yang-json/60Keyboard/00Key-master/images/1.JPG

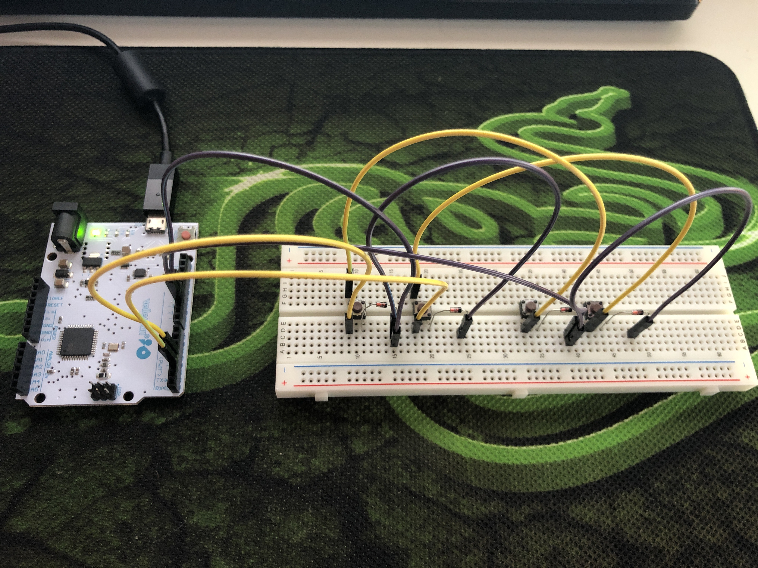
00Key-master/images/1.JPG
