yang-json/60Keyboard/00Key-master/images/5.jpeg

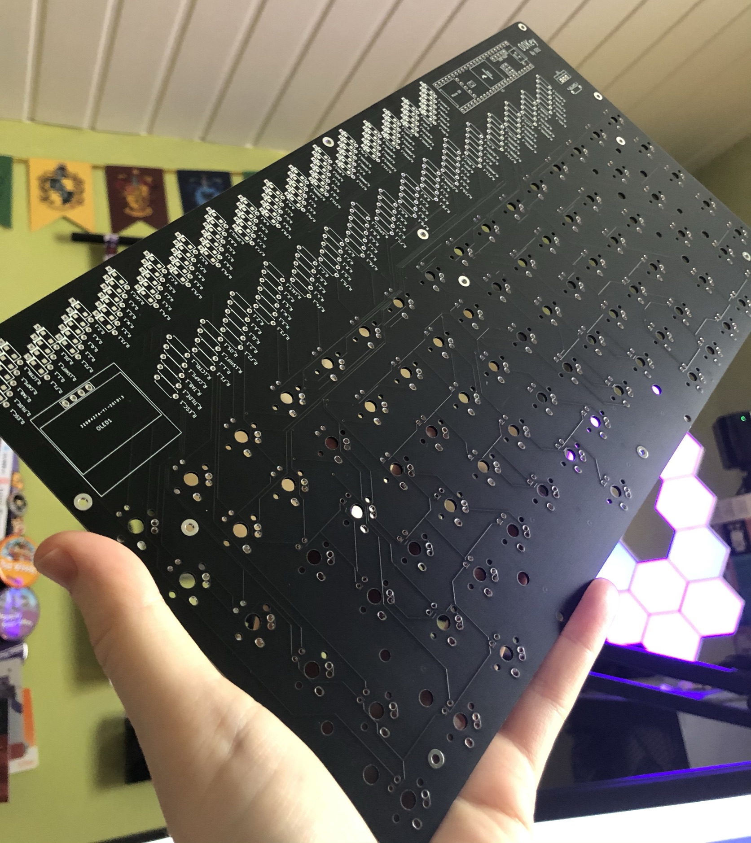
00Key-master/images/5.jpeg
