yang-json/60Keyboard/00Key-master/images/6.jpeg

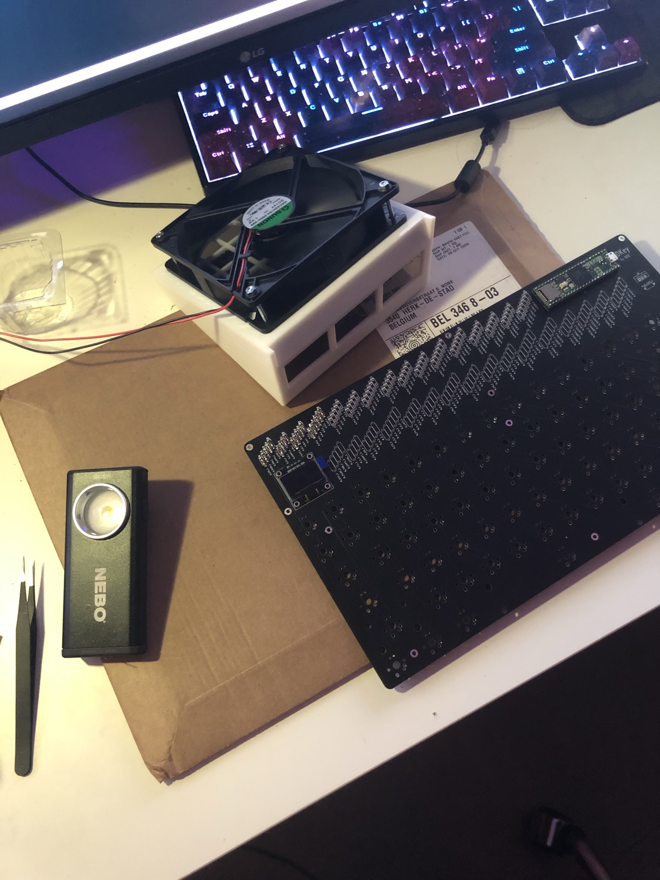
00Key-master/images/6.jpeg
