yang-json/60Keyboard/00Key-master/images/7.jpeg

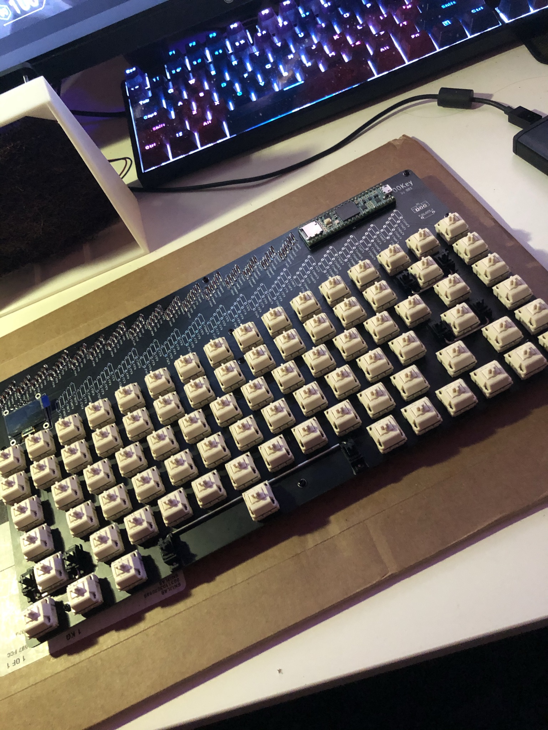
00Key-master/images/7.jpeg
