yang-json/60Keyboard/00Key-master/images/9.jpeg

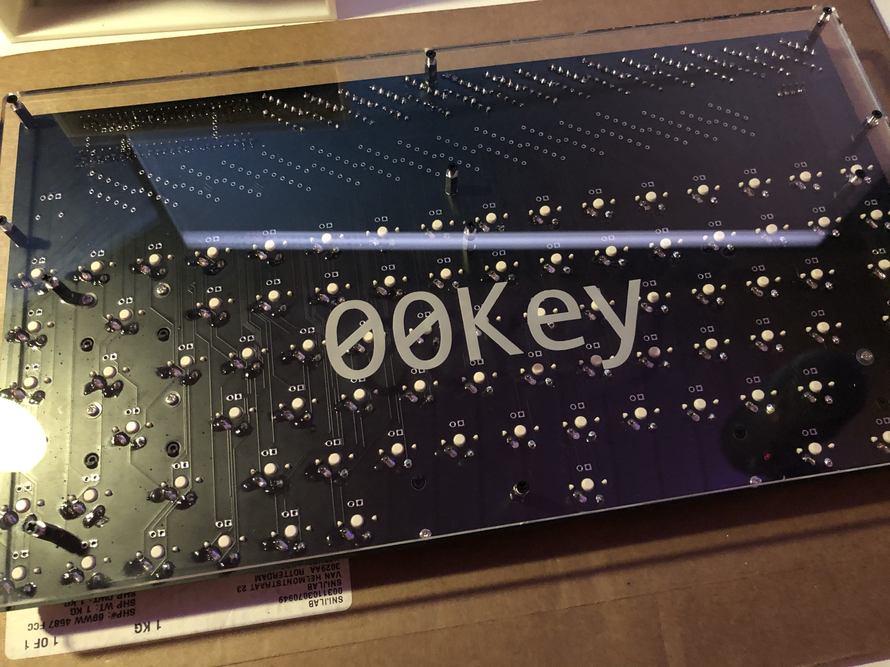
00Key-master/images/9.jpeg
