yang-json/60Keyboard/00Key-master/images/10.jpeg

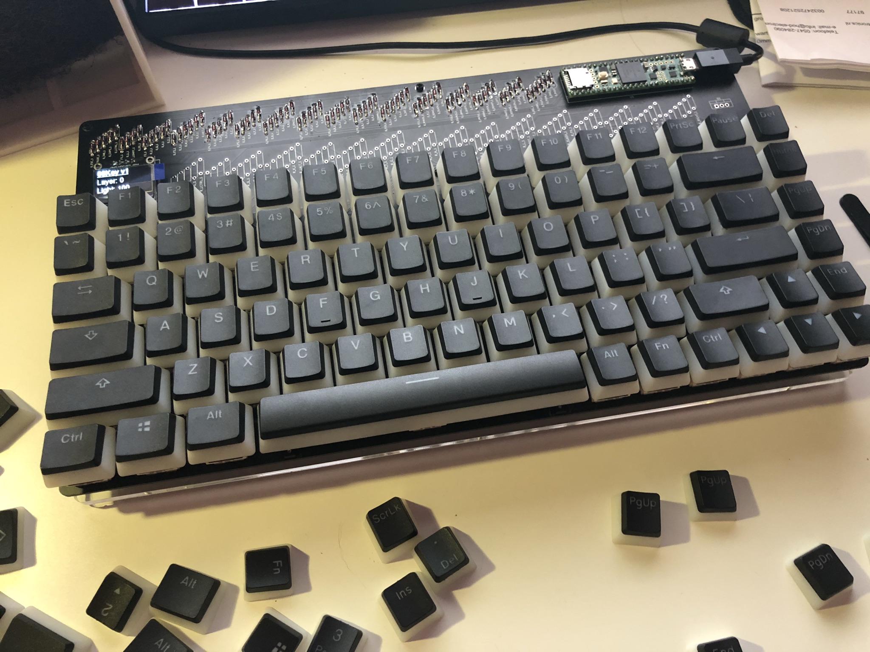
00Key-master/images/10.jpeg
