yang-json/60Keyboard/00Key-master/reference/pins.png

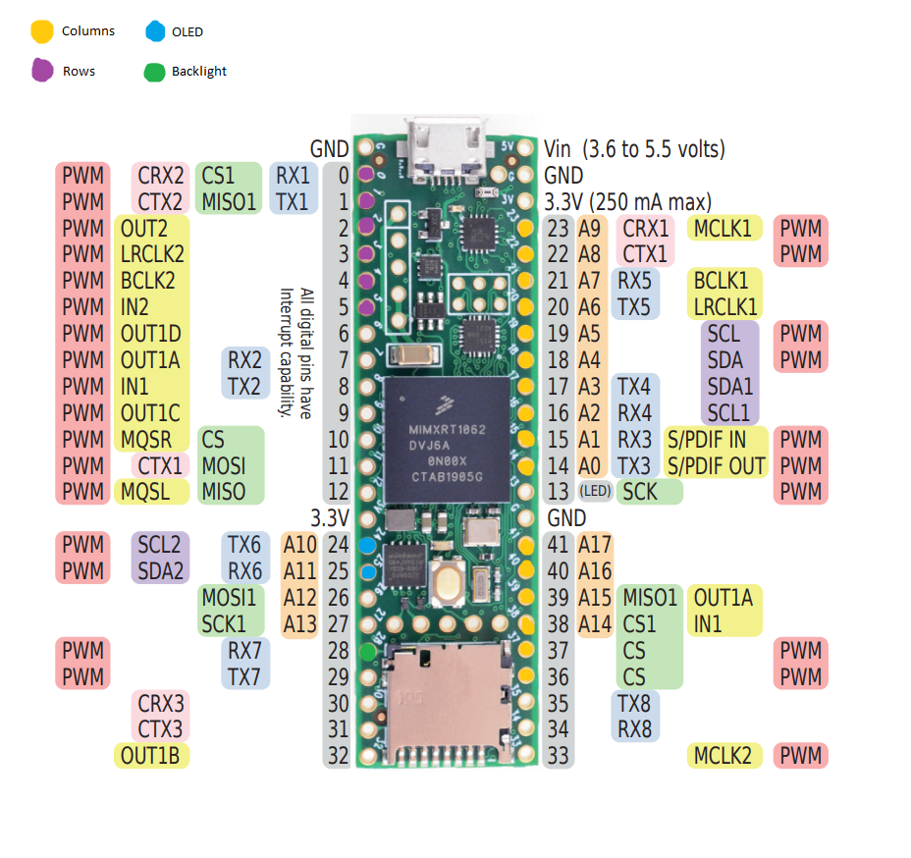
00Key-master/reference/pins.png
