yang-json/60Keyboard/Board layout.png

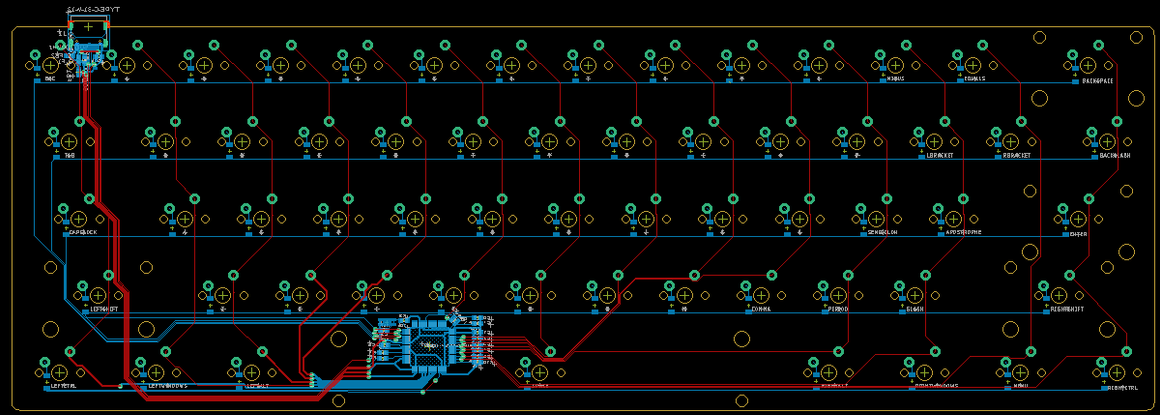
Board layout.png
