yang-json/60Keyboard/PCB bottom.png

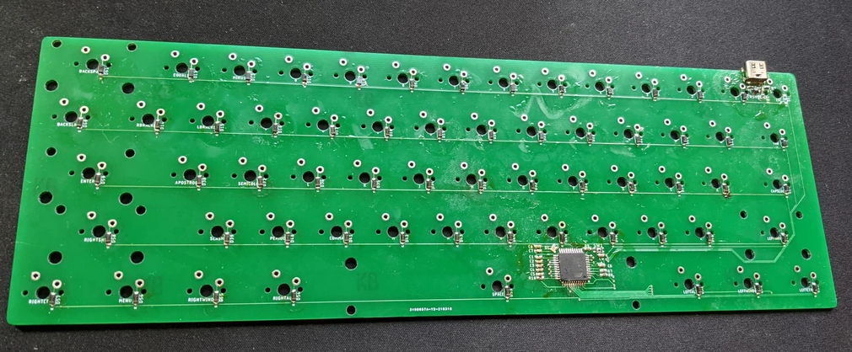
PCB bottom.png
