yang-json/60Keyboard/PCB schematic.png

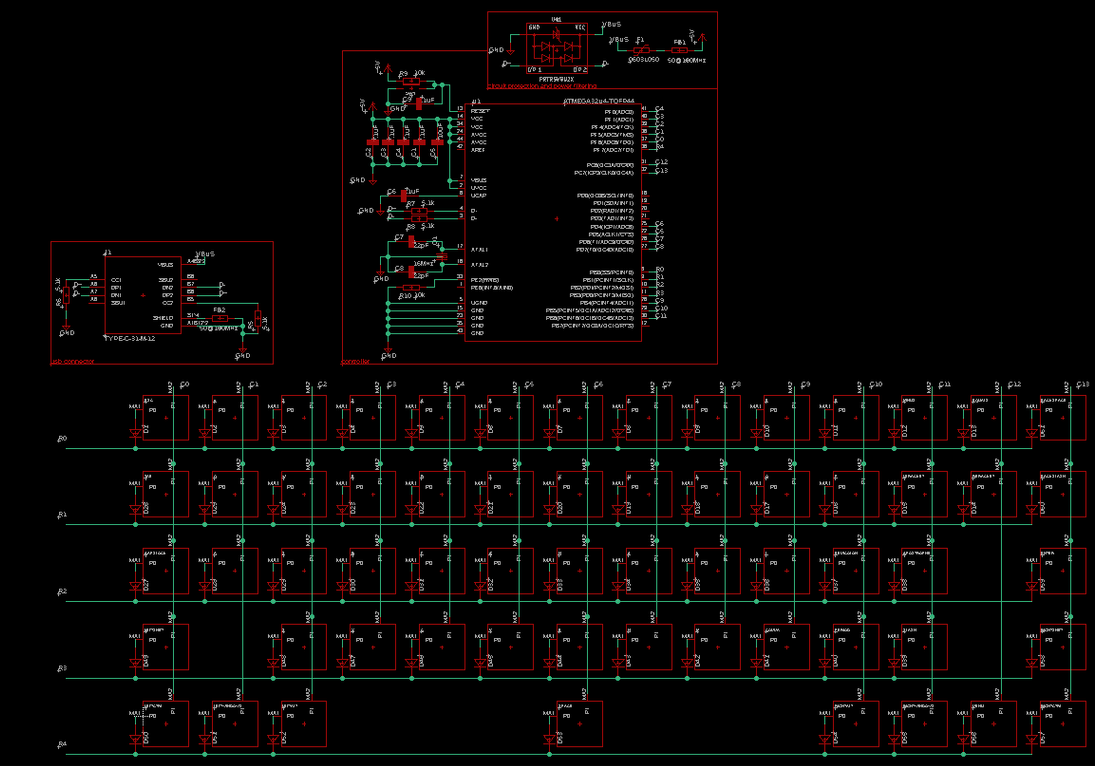
PCB schematic.png
