yang-json/60Keyboard/PCB top.png

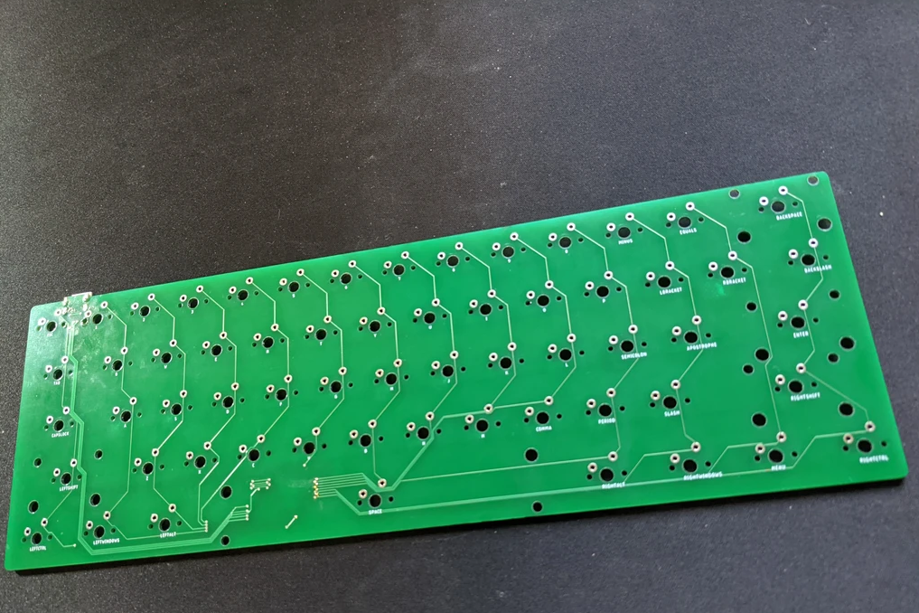
PCB top.png
