yang-json/60Keyboard/00Key-master/raiser/CAD/raiser.FCStd

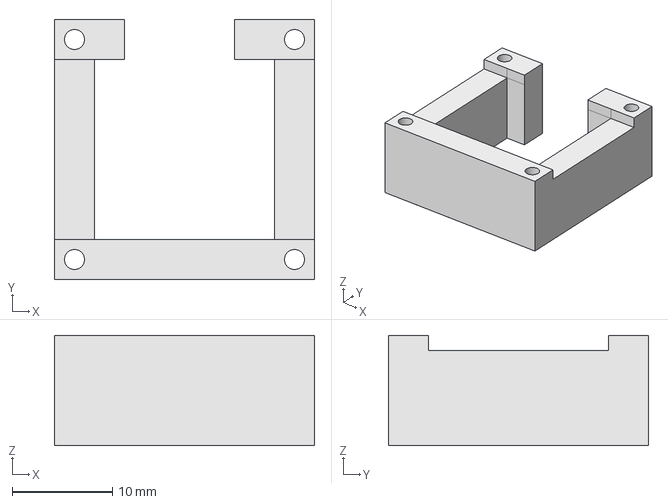
[picture p18: CAD file, 2024-01-08]
00Key-master/raiser/CAD/raiser.FCStd
26.0 x 26.0 x 11.0 mm
