yang-json/60Keyboard/00Key-master/underglow/CAD/underglow spacer.FCStd

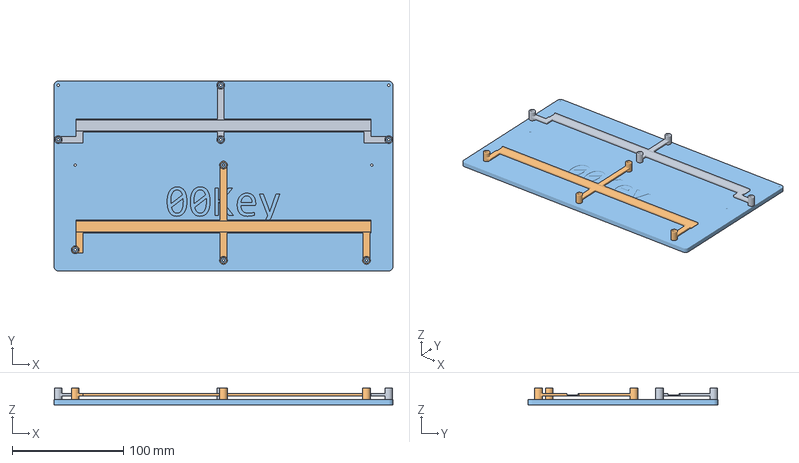
[picture p19: CAD file, 2024-01-08]
00Key-master/underglow/CAD/underglow spacer.FCStd
304.8 x 170.8 x 15.0 mm
top_all
bottom_all
plate
