yang-json/60Keyboard/00Key-master/underglow/STL/underglow_spacer_top.stl

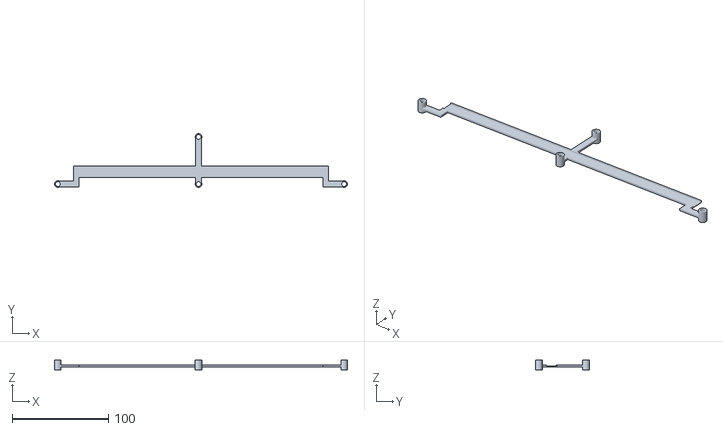
[picture p20: CAD file, 2024-01-08]
00Key-master/underglow/STL/underglow_spacer_top.stl
304.2 x 55.8 x 10.0
