yang-json/60Keyboard/a1d715fa3ec649b463cb42fbbe5cdb0abbd753b8_switch.dxf

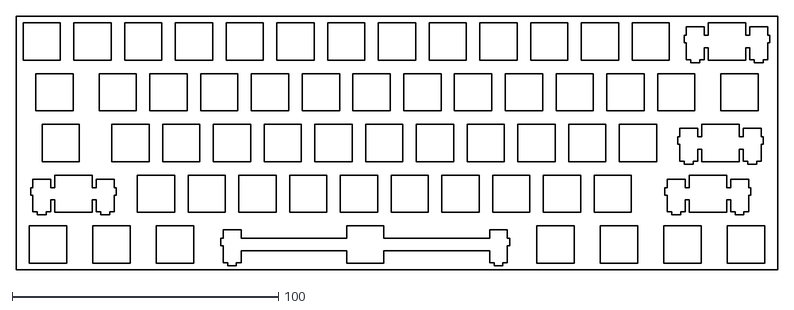
[picture p21: CAD file, 2024-01-08]
a1d715fa3ec649b463cb42fbbe5cdb0abbd753b8_switch.dxf
285.7 x 95.2
