yang-json/60Keyboard/00Key-master/plate/stl/right.stl

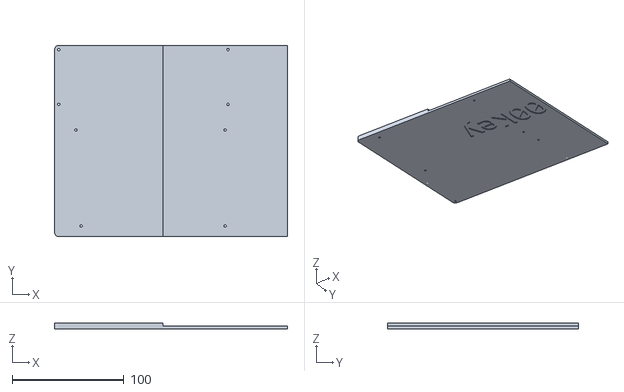
[picture p22: CAD file, 2024-01-08]
00Key-master/plate/stl/right.stl
208.1 x 170.8 x 5.00
