yang-json/60Keyboard/00Key-master/underglow/STL/underglow_spacer_bottom.stl

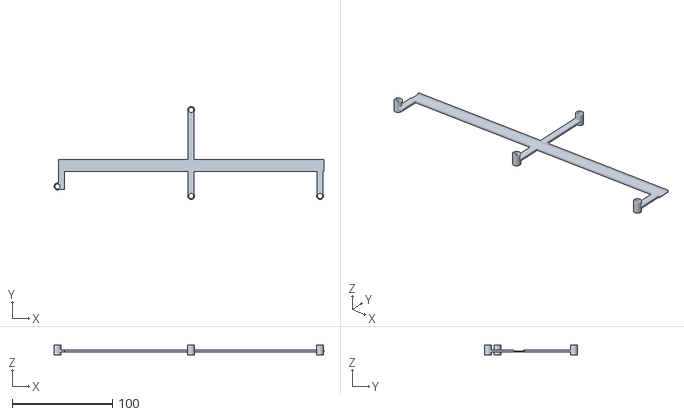
[picture p23: CAD file, 2024-01-08]
00Key-master/underglow/STL/underglow_spacer_bottom.stl
269.3 x 92.7 x 10.0
