yang-json/60Keyboard/00Key-master/underglow/STL/spacer.stl

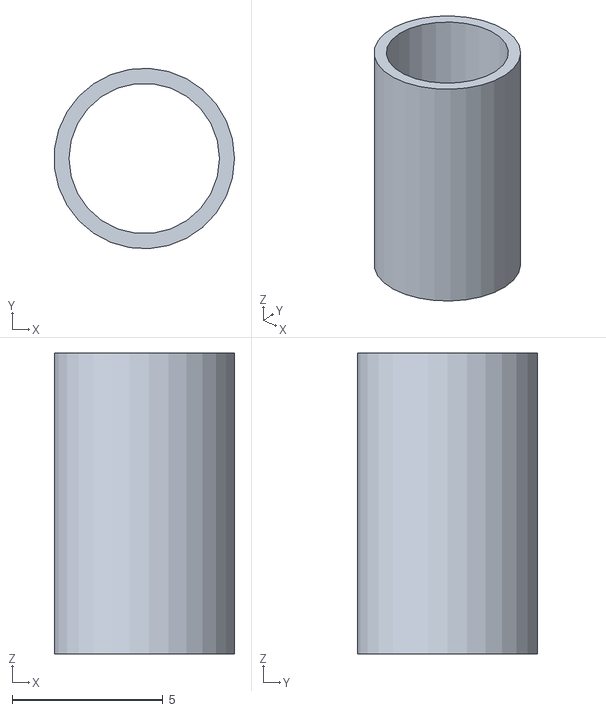
[picture p24: CAD file, 2024-01-08]
00Key-master/underglow/STL/spacer.stl
5.98 x 5.99 x 10.0
