yang-json/60Keyboard/(list of files, cad)

Other CAD files:
00Key-master/raiser/STL/raiser.stl
a1d715fa3ec649b463cb42fbbe5cdb0abbd753b8_switch.dwg
