yang-json/60Keyboard/00Key-master/images/build/DSCF2624.JPG

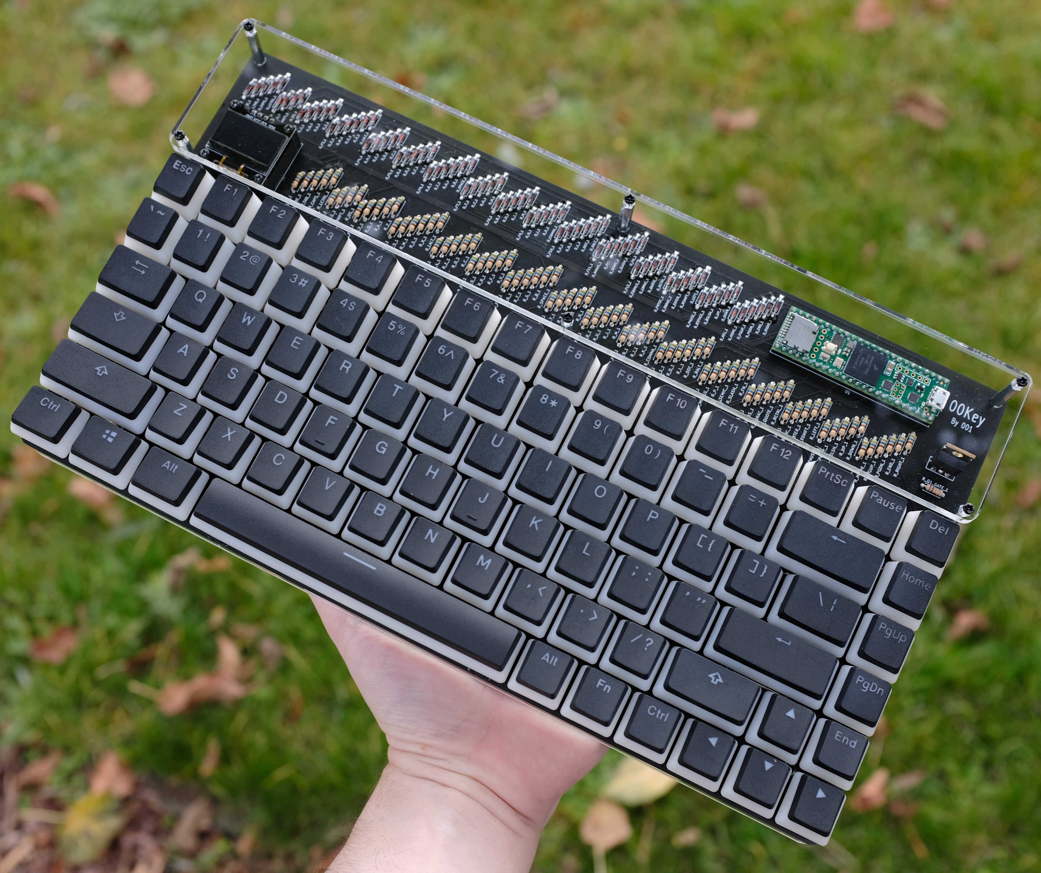
00Key-master/images/build/DSCF2624.JPG
