yang-json/60Keyboard/PCB assembled.png

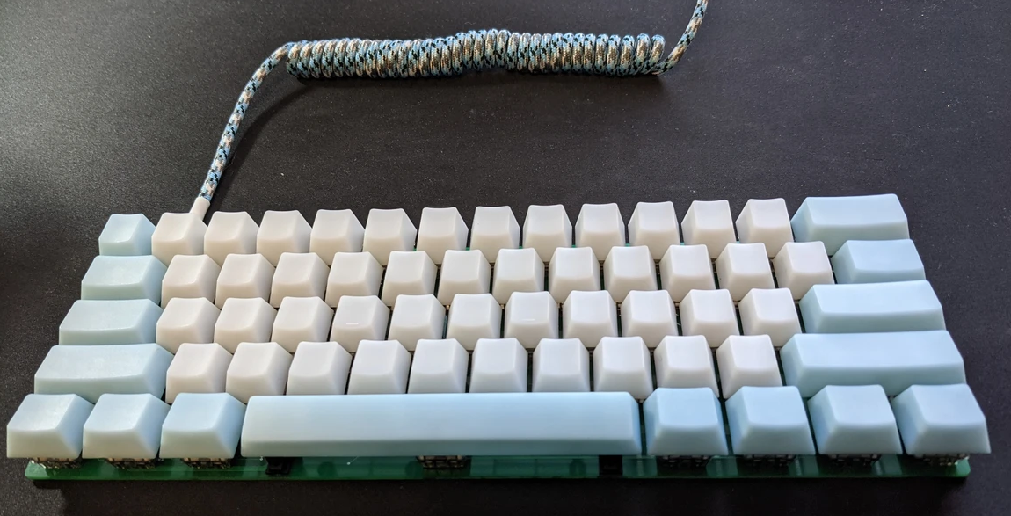
PCB assembled.png
