yang-json/60Keyboard/(list of files, drawings)

Other design files:
00Key-master/pcb/freerouting/00Key-out.dsn
00Key-master/pcb/freerouting/00Key.dsn
