yang-json/60Keyboard/00Key-master/pcb/kicad/00Key.kicad_pcb

## KiCad design 00Key-master/pcb/kicad/00Key.kicad_pcb (2024-01-08)

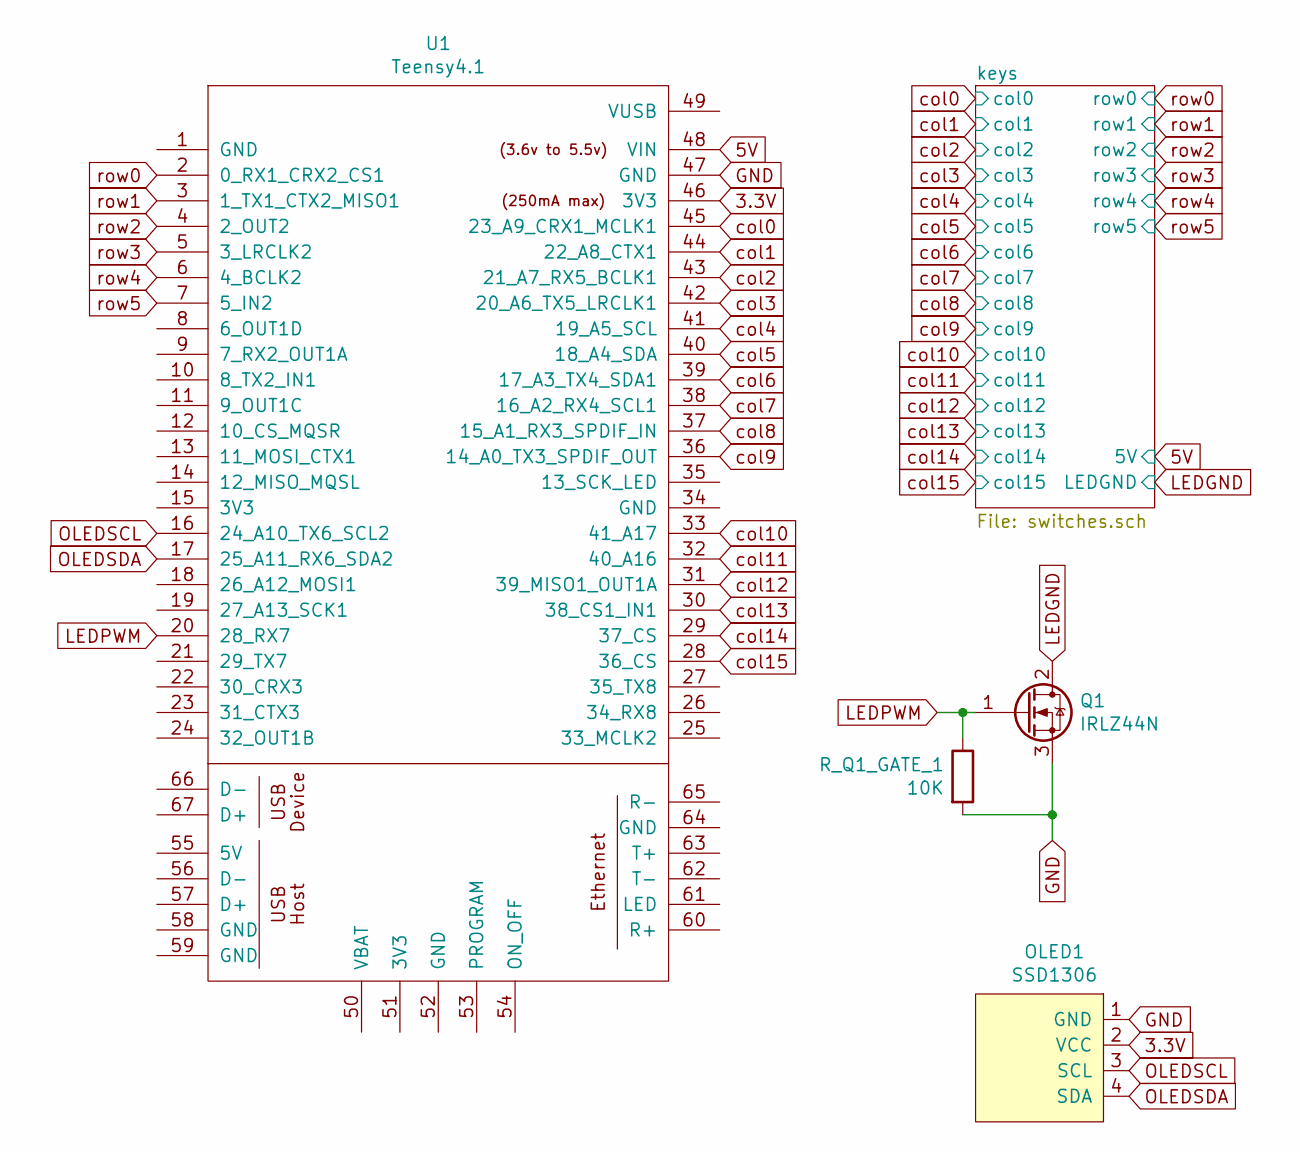
[picture p27: schematic 00Key.sch]

Parts:
OLED1: SSD1306; 128x64OLED
Q1: IRLZ44N; TO-220-3_Vertical
R_Q1_GATE_1: 10K; R_Axial_DIN0207_L6.3mm_D2.5mm_P7.62mm_Horizontal
U1: Teensy4.1; Teensy41

Connections:
3.3V: OLED1.2 (VCC), U1.46 (3V3)
5V: U1.48 (VIN); also elsewhere on the board
GND: OLED1.1 (GND), Q1.3 (S), R_Q1_GATE_1.2, U1.47 (GND)
LEDGND: Q1.2 (D); also elsewhere on the board
LEDPWM: Q1.1 (G), R_Q1_GATE_1.1, U1.20 (28_RX7)
OLEDSCL: OLED1.3 (SCL), U1.16 (24_A10_TX6_SCL2)
OLEDSDA: OLED1.4 (SDA), U1.17 (25_A11_RX6_SDA2)
col0: U1.45 (23_A9_CRX1_MCLK1); also elsewhere on the board
col1: U1.44 (22_A8_CTX1); also elsewhere on the board
col2: U1.43 (21_A7_RX5_BCLK1); also elsewhere on the board
col3: U1.42 (20_A6_TX5_LRCLK1); also elsewhere on the board
col4: U1.41 (19_A5_SCL); also elsewhere on the board
col5: U1.40 (18_A4_SDA); also elsewhere on the board
col6: U1.39 (17_A3_TX4_SDA1); also elsewhere on the board
col7: U1.38 (16_A2_RX4_SCL1); also elsewhere on the board
col8: U1.37 (15_A1_RX3_SPDIF_IN); also elsewhere on the board
col9: U1.36 (14_A0_TX3_SPDIF_OUT); also elsewhere on the board
col10: U1.33 (41_A17); also elsewhere on the board
col11: U1.32 (40_A16); also elsewhere on the board
col12: U1.31 (39_MISO1_OUT1A); also elsewhere on the board
col13: U1.30 (38_CS1_IN1); also elsewhere on the board
col14: U1.29 (37_CS); also elsewhere on the board
col15: U1.28 (36_CS); also elsewhere on the board
row0: U1.2 (0_RX1_CRX2_CS1); also elsewhere on the board
row1: U1.3 (1_TX1_CTX2_MISO1); also elsewhere on the board
row2: U1.4 (2_OUT2); also elsewhere on the board
row3: U1.5 (3_LRCLK2); also elsewhere on the board
row4: U1.6 (4_BCLK2); also elsewhere on the board
row5: U1.7 (5_IN2); also elsewhere on the board

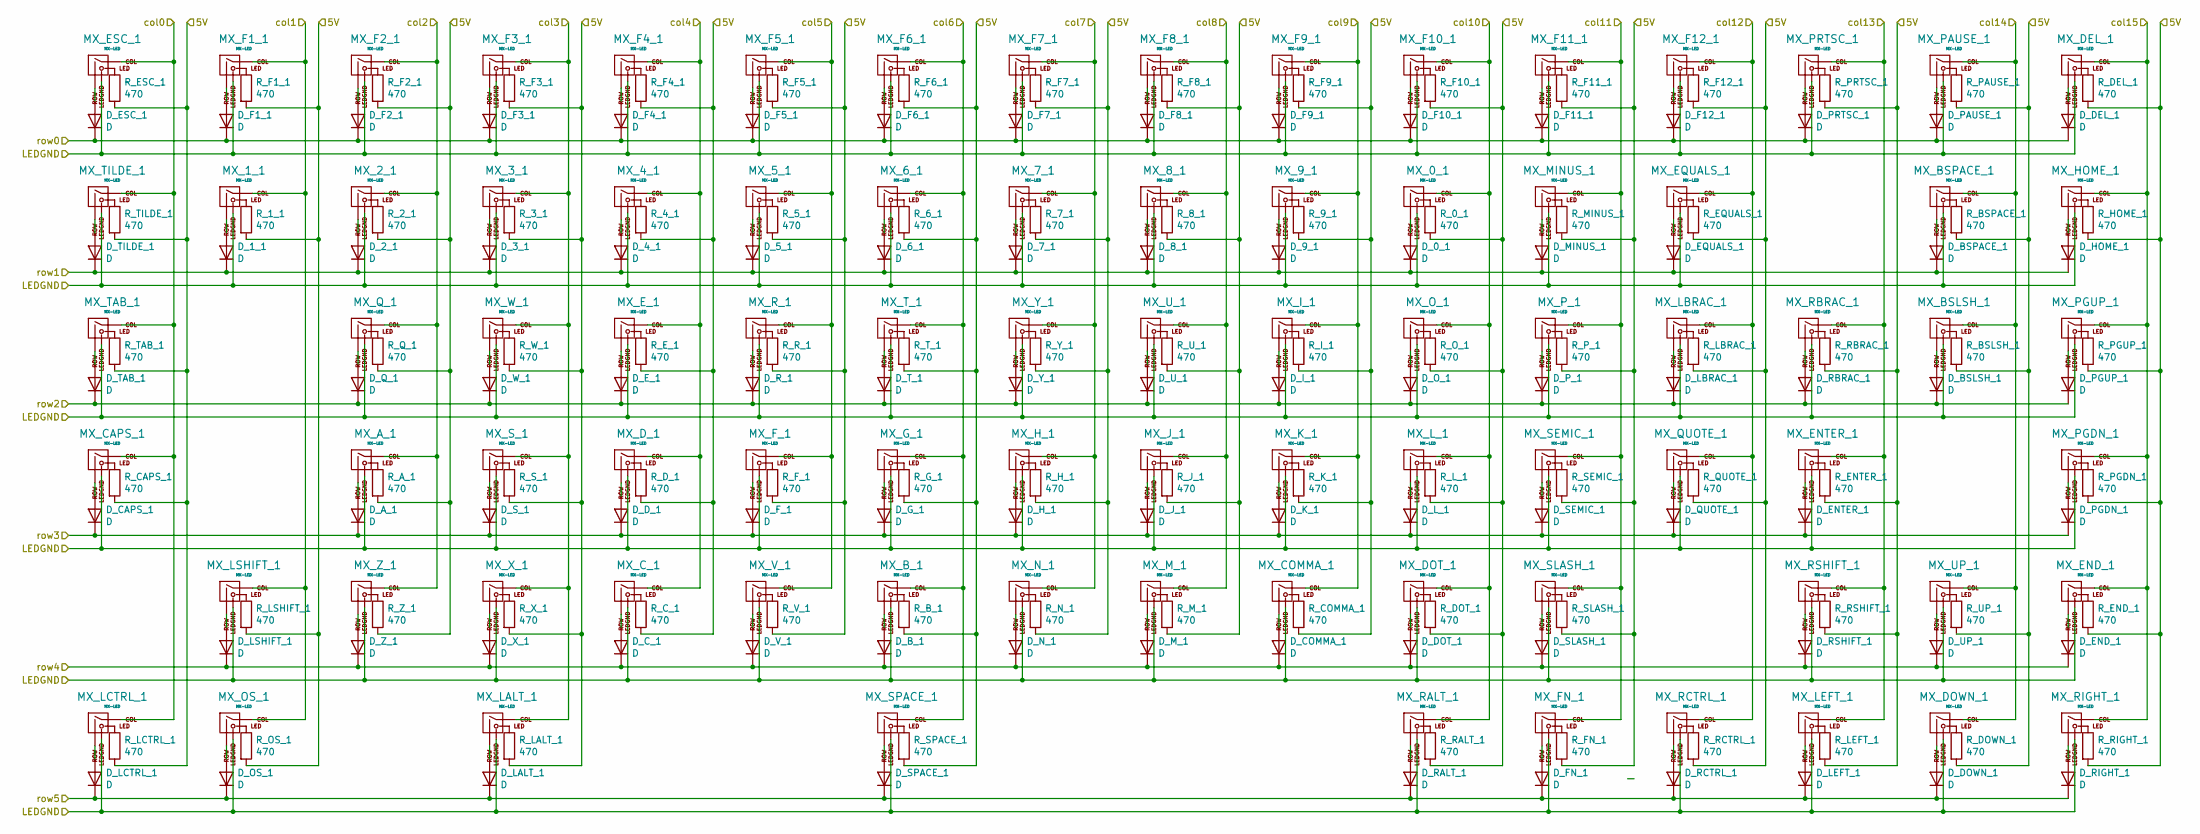
[picture p28: schematic switches.sch]

Parts:
D_0_1, D_1_1, D_2_1, D_3_1, D_4_1, D_5_1, D_6_1, D_7_1, D_8_1, D_9_1: D; D_SOD123_axial
D_A_1: D; D_SOD123_axial
D_BSLSH_1: D; D_SOD123_axial
D_BSPACE_1: D; D_SOD123_axial
D_B_1: D; D_SOD123_axial
D_CAPS_1: D; D_SOD123_axial
D_COMMA_1: D; D_SOD123_axial
D_C_1: D; D_SOD123_axial
D_DEL_1: D; D_SOD123_axial
D_DOT_1: D; D_SOD123_axial
D_DOWN_1: D; D_SOD123_axial
D_D_1: D; D_SOD123_axial
D_END_1: D; D_SOD123_axial
D_ENTER_1: D; D_SOD123_axial
D_EQUALS_1: D; D_SOD123_axial
D_ESC_1: D; D_SOD123_axial
D_E_1: D; D_SOD123_axial
D_F1_1, D_F2_1, D_F3_1, D_F4_1, D_F5_1, D_F6_1, D_F7_1, D_F8_1, D_F9_1, D_F10_1, D_F11_1, D_F12_1: D; D_SOD123_axial
D_FN_1: D; D_SOD123_axial
D_F_1: D; D_SOD123_axial
D_G_1: D; D_SOD123_axial
D_HOME_1: D; D_SOD123_axial
D_H_1: D; D_SOD123_axial
D_I_1: D; D_SOD123_axial
D_J_1: D; D_SOD123_axial
D_K_1: D; D_SOD123_axial
D_LALT_1: D; D_SOD123_axial
D_LBRAC_1: D; D_SOD123_axial
D_LCTRL_1: D; D_SOD123_axial
D_LEFT_1: D; D_SOD123_axial
D_LSHIFT_1: D; D_SOD123_axial
D_L_1: D; D_SOD123_axial
D_MINUS_1: D; D_SOD123_axial
D_M_1: D; D_SOD123_axial
D_N_1: D; D_SOD123_axial
D_OS_1: D; D_SOD123_axial
D_O_1: D; D_SOD123_axial
D_PAUSE_1: D; D_SOD123_axial
D_PGDN_1: D; D_SOD123_axial
D_PGUP_1: D; D_SOD123_axial
D_PRTSC_1: D; D_SOD123_axial
D_P_1: D; D_SOD123_axial
D_QUOTE_1: D; D_SOD123_axial
D_Q_1: D; D_SOD123_axial
D_RALT_1: D; D_SOD123_axial
D_RBRAC_1: D; D_SOD123_axial
D_RCTRL_1: D; D_SOD123_axial
D_RIGHT_1: D; D_SOD123_axial
D_RSHIFT_1: D; D_SOD123_axial
D_R_1: D; D_SOD123_axial
D_SEMIC_1: D; D_SOD123_axial
D_SLASH_1: D; D_SOD123_axial
D_SPACE_1: D; D_SOD123_axial
D_S_1: D; D_SOD123_axial
D_TAB_1: D; D_SOD123_axial
D_TILDE_1: D; D_SOD123_axial
D_T_1: D; D_SOD123_axial
D_UP_1: D; D_SOD123_axial
D_U_1: D; D_SOD123_axial
D_V_1: D; D_SOD123_axial
D_W_1: D; D_SOD123_axial
D_X_1: D; D_SOD123_axial
D_Y_1: D; D_SOD123_axial
D_Z_1: D; D_SOD123_axial
MX_0_1, MX_1_1, MX_2_1, MX_3_1, MX_4_1, MX_5_1, MX_6_1, MX_7_1, MX_8_1, MX_9_1: MX-LED; MX-1U
MX_A_1: MX-LED; MX-1U
MX_BSLSH_1: MX-LED; MX-1.5U
MX_BSPACE_1: MX-LED; MX-2U-ReversedStabilizers
MX_B_1: MX-LED; MX-1U
MX_CAPS_1: MX-LED; MX-1.75U
MX_COMMA_1: MX-LED; MX-1U
MX_C_1: MX-LED; MX-1U
MX_DEL_1: MX-LED; MX-1U
MX_DOT_1: MX-LED; MX-1U
MX_DOWN_1: MX-LED; MX-1U
MX_D_1: MX-LED; MX-1U
MX_END_1: MX-LED; MX-1U
MX_ENTER_1: MX-LED; MX-2.25U-ReversedStabilizers
MX_EQUALS_1: MX-LED; MX-1U
MX_ESC_1: MX-LED; MX-1U
MX_E_1: MX-LED; MX-1U
MX_F1_1, MX_F2_1, MX_F3_1, MX_F4_1, MX_F5_1, MX_F6_1, MX_F7_1, MX_F8_1, MX_F9_1, MX_F10_1, MX_F11_1, MX_F12_1: MX-LED; MX-1U
MX_FN_1: MX-LED; MX-1U
MX_F_1: MX-LED; MX-1U
MX_G_1: MX-LED; MX-1U
MX_HOME_1: MX-LED; MX-1U
MX_H_1: MX-LED; MX-1U
MX_I_1: MX-LED; MX-1U
MX_J_1: MX-LED; MX-1U
MX_K_1: MX-LED; MX-1U
MX_LALT_1: MX-LED; MX-1.25U
MX_LBRAC_1: MX-LED; MX-1U
MX_LCTRL_1: MX-LED; MX-1.25U
MX_LEFT_1: MX-LED; MX-1U
MX_LSHIFT_1: MX-LED; MX-2.25U-ReversedStabilizers
MX_L_1: MX-LED; MX-1U
MX_MINUS_1: MX-LED; MX-1U
MX_M_1: MX-LED; MX-1U
MX_N_1: MX-LED; MX-1U
MX_OS_1: MX-LED; MX-1.25U
MX_O_1: MX-LED; MX-1U
MX_PAUSE_1: MX-LED; MX-1U
MX_PGDN_1: MX-LED; MX-1U
MX_PGUP_1: MX-LED; MX-1U
MX_PRTSC_1: MX-LED; MX-1U
MX_P_1: MX-LED; MX-1U
MX_QUOTE_1: MX-LED; MX-1U
MX_Q_1: MX-LED; MX-1U
MX_RALT_1: MX-LED; MX-1U
MX_RBRAC_1: MX-LED; MX-1U
MX_RCTRL_1: MX-LED; MX-1U
MX_RIGHT_1: MX-LED; MX-1U
MX_RSHIFT_1: MX-LED; MX-1.75U
MX_R_1: MX-LED; MX-1U
MX_SEMIC_1: MX-LED; MX-1U
MX_SLASH_1: MX-LED; MX-1U
MX_SPACE_1: MX-LED; MX-6.25U
MX_S_1: MX-LED; MX-1U
MX_TAB_1: MX-LED; MX-1.5U
MX_TILDE_1: MX-LED; MX-1U
MX_T_1: MX-LED; MX-1U
MX_UP_1: MX-LED; MX-1U
MX_U_1: MX-LED; MX-1U
MX_V_1: MX-LED; MX-1U
MX_W_1: MX-LED; MX-1U
MX_X_1: MX-LED; MX-1U
MX_Y_1: MX-LED; MX-1U
MX_Z_1: MX-LED; MX-1U
R_0_1, R_1_1, R_2_1, R_3_1, R_4_1, R_5_1, R_6_1, R_7_1, R_8_1, R_9_1: 470; R_Axial_DIN0207_L6.3mm_D2.5mm_P7.62mm_Horizontal
R_A_1: 470; R_Axial_DIN0207_L6.3mm_D2.5mm_P7.62mm_Horizontal
R_BSLSH_1: 470; R_Axial_DIN0207_L6.3mm_D2.5mm_P7.62mm_Horizontal
R_BSPACE_1: 470; R_Axial_DIN0207_L6.3mm_D2.5mm_P7.62mm_Horizontal
R_B_1: 470; R_Axial_DIN0207_L6.3mm_D2.5mm_P7.62mm_Horizontal
R_CAPS_1: 470; R_Axial_DIN0207_L6.3mm_D2.5mm_P7.62mm_Horizontal
R_COMMA_1: 470; R_Axial_DIN0207_L6.3mm_D2.5mm_P7.62mm_Horizontal
R_C_1: 470; R_Axial_DIN0207_L6.3mm_D2.5mm_P7.62mm_Horizontal
R_DEL_1: 470; R_Axial_DIN0207_L6.3mm_D2.5mm_P7.62mm_Horizontal
R_DOT_1: 470; R_Axial_DIN0207_L6.3mm_D2.5mm_P7.62mm_Horizontal
R_DOWN_1: 470; R_Axial_DIN0207_L6.3mm_D2.5mm_P7.62mm_Horizontal
R_D_1: 470; R_Axial_DIN0207_L6.3mm_D2.5mm_P7.62mm_Horizontal
R_END_1: 470; R_Axial_DIN0207_L6.3mm_D2.5mm_P7.62mm_Horizontal
R_ENTER_1: 470; R_Axial_DIN0207_L6.3mm_D2.5mm_P7.62mm_Horizontal
R_EQUALS_1: 470; R_Axial_DIN0207_L6.3mm_D2.5mm_P7.62mm_Horizontal
R_ESC_1: 470; R_Axial_DIN0207_L6.3mm_D2.5mm_P7.62mm_Horizontal
R_E_1: 470; R_Axial_DIN0207_L6.3mm_D2.5mm_P7.62mm_Horizontal
R_F1_1, R_F2_1, R_F3_1, R_F4_1, R_F5_1, R_F6_1, R_F7_1, R_F8_1, R_F9_1, R_F10_1, R_F11_1, R_F12_1: 470; R_Axial_DIN0207_L6.3mm_D2.5mm_P7.62mm_Horizontal
R_FN_1: 470; R_Axial_DIN0207_L6.3mm_D2.5mm_P7.62mm_Horizontal
R_F_1: 470; R_Axial_DIN0207_L6.3mm_D2.5mm_P7.62mm_Horizontal
R_G_1: 470; R_Axial_DIN0207_L6.3mm_D2.5mm_P7.62mm_Horizontal
R_HOME_1: 470; R_Axial_DIN0207_L6.3mm_D2.5mm_P7.62mm_Horizontal
R_H_1: 470; R_Axial_DIN0207_L6.3mm_D2.5mm_P7.62mm_Horizontal
R_I_1: 470; R_Axial_DIN0207_L6.3mm_D2.5mm_P7.62mm_Horizontal
R_J_1: 470; R_Axial_DIN0207_L6.3mm_D2.5mm_P7.62mm_Horizontal
R_K_1: 470; R_Axial_DIN0207_L6.3mm_D2.5mm_P7.62mm_Horizontal
R_LALT_1: 470; R_Axial_DIN0207_L6.3mm_D2.5mm_P7.62mm_Horizontal
R_LBRAC_1: 470; R_Axial_DIN0207_L6.3mm_D2.5mm_P7.62mm_Horizontal
R_LCTRL_1: 470; R_Axial_DIN0207_L6.3mm_D2.5mm_P7.62mm_Horizontal
R_LEFT_1: 470; R_Axial_DIN0207_L6.3mm_D2.5mm_P7.62mm_Horizontal
R_LSHIFT_1: 470; R_Axial_DIN0207_L6.3mm_D2.5mm_P7.62mm_Horizontal
R_L_1: 470; R_Axial_DIN0207_L6.3mm_D2.5mm_P7.62mm_Horizontal
R_MINUS_1: 470; R_Axial_DIN0207_L6.3mm_D2.5mm_P7.62mm_Horizontal
R_M_1: 470; R_Axial_DIN0207_L6.3mm_D2.5mm_P7.62mm_Horizontal
R_N_1: 470; R_Axial_DIN0207_L6.3mm_D2.5mm_P7.62mm_Horizontal
R_OS_1: 470; R_Axial_DIN0207_L6.3mm_D2.5mm_P7.62mm_Horizontal
R_O_1: 470; R_Axial_DIN0207_L6.3mm_D2.5mm_P7.62mm_Horizontal
R_PAUSE_1: 470; R_Axial_DIN0207_L6.3mm_D2.5mm_P7.62mm_Horizontal
R_PGDN_1: 470; R_Axial_DIN0207_L6.3mm_D2.5mm_P7.62mm_Horizontal
R_PGUP_1: 470; R_Axial_DIN0207_L6.3mm_D2.5mm_P7.62mm_Horizontal
R_PRTSC_1: 470; R_Axial_DIN0207_L6.3mm_D2.5mm_P7.62mm_Horizontal
R_P_1: 470; R_Axial_DIN0207_L6.3mm_D2.5mm_P7.62mm_Horizontal
R_QUOTE_1: 470; R_Axial_DIN0207_L6.3mm_D2.5mm_P7.62mm_Horizontal
R_Q_1: 470; R_Axial_DIN0207_L6.3mm_D2.5mm_P7.62mm_Horizontal
R_RALT_1: 470; R_Axial_DIN0207_L6.3mm_D2.5mm_P7.62mm_Horizontal
R_RBRAC_1: 470; R_Axial_DIN0207_L6.3mm_D2.5mm_P7.62mm_Horizontal
R_RCTRL_1: 470; R_Axial_DIN0207_L6.3mm_D2.5mm_P7.62mm_Horizontal
R_RIGHT_1: 470; R_Axial_DIN0207_L6.3mm_D2.5mm_P7.62mm_Horizontal
R_RSHIFT_1: 470; R_Axial_DIN0207_L6.3mm_D2.5mm_P7.62mm_Horizontal
R_R_1: 470; R_Axial_DIN0207_L6.3mm_D2.5mm_P7.62mm_Horizontal
R_SEMIC_1: 470; R_Axial_DIN0207_L6.3mm_D2.5mm_P7.62mm_Horizontal
R_SLASH_1: 470; R_Axial_DIN0207_L6.3mm_D2.5mm_P7.62mm_Horizontal
R_SPACE_1: 470; R_Axial_DIN0207_L6.3mm_D2.5mm_P7.62mm_Horizontal
R_S_1: 470; R_Axial_DIN0207_L6.3mm_D2.5mm_P7.62mm_Horizontal
R_TAB_1: 470; R_Axial_DIN0207_L6.3mm_D2.5mm_P7.62mm_Horizontal
R_TILDE_1: 470; R_Axial_DIN0207_L6.3mm_D2.5mm_P7.62mm_Horizontal
R_T_1: 470; R_Axial_DIN0207_L6.3mm_D2.5mm_P7.62mm_Horizontal
R_UP_1: 470; R_Axial_DIN0207_L6.3mm_D2.5mm_P7.62mm_Horizontal
R_U_1: 470; R_Axial_DIN0207_L6.3mm_D2.5mm_P7.62mm_Horizontal
R_V_1: 470; R_Axial_DIN0207_L6.3mm_D2.5mm_P7.62mm_Horizontal
R_W_1: 470; R_Axial_DIN0207_L6.3mm_D2.5mm_P7.62mm_Horizontal
R_X_1: 470; R_Axial_DIN0207_L6.3mm_D2.5mm_P7.62mm_Horizontal
R_Y_1: 470; R_Axial_DIN0207_L6.3mm_D2.5mm_P7.62mm_Horizontal
R_Z_1: 470; R_Axial_DIN0207_L6.3mm_D2.5mm_P7.62mm_Horizontal

Connections:
5V: R_0_1.2, R_1_1.2, R_2_1.2, R_3_1.2, R_4_1.2, R_5_1.2, R_6_1.2, R_7_1.2, R_8_1.2, R_9_1.2, R_A_1.2, R_BSLSH_1.2, R_BSPACE_1.2, R_B_1.2, R_CAPS_1.2, R_COMMA_1.2, R_C_1.2, R_DEL_1.2, R_DOT_1.2, R_DOWN_1.2, R_D_1.2, R_END_1.2, R_ENTER_1.2, R_EQUALS_1.2, R_ESC_1.2, R_E_1.2, R_F1_1.2, R_F2_1.2, R_F3_1.2, R_F4_1.2, R_F5_1.2, R_F6_1.2, R_F7_1.2, R_F8_1.2, R_F9_1.2, R_F10_1.2, R_F11_1.2, R_F12_1.2, R_FN_1.2, R_F_1.2, R_G_1.2, R_HOME_1.2, R_H_1.2, R_I_1.2, R_J_1.2, R_K_1.2, R_LALT_1.2, R_LBRAC_1.2, R_LCTRL_1.2, R_LEFT_1.2, R_LSHIFT_1.2, R_L_1.2, R_MINUS_1.2, R_M_1.2, R_N_1.2, R_OS_1.2, R_O_1.2, R_PAUSE_1.2, R_PGDN_1.2, R_PGUP_1.2, R_PRTSC_1.2, R_P_1.2, R_QUOTE_1.2, R_Q_1.2, R_RALT_1.2, R_RBRAC_1.2, R_RCTRL_1.2, R_RIGHT_1.2, R_RSHIFT_1.2, R_R_1.2, R_SEMIC_1.2, R_SLASH_1.2, R_SPACE_1.2, R_S_1.2, R_TAB_1.2, R_TILDE_1.2, R_T_1.2, R_UP_1.2, R_U_1.2, R_V_1.2, R_W_1.2, R_X_1.2, R_Y_1.2, R_Z_1.2; also elsewhere on the board
LEDGND: MX_0_1.4 (LEDGND), MX_1_1.4 (LEDGND), MX_2_1.4 (LEDGND), MX_3_1.4 (LEDGND), MX_4_1.4 (LEDGND), MX_5_1.4 (LEDGND), MX_6_1.4 (LEDGND), MX_7_1.4 (LEDGND), MX_8_1.4 (LEDGND), MX_9_1.4 (LEDGND), MX_A_1.4 (LEDGND), MX_BSLSH_1.4 (LEDGND), MX_BSPACE_1.4 (LEDGND), MX_B_1.4 (LEDGND), MX_CAPS_1.4 (LEDGND), MX_COMMA_1.4 (LEDGND), MX_C_1.4 (LEDGND), MX_DEL_1.4 (LEDGND), MX_DOT_1.4 (LEDGND), MX_DOWN_1.4 (LEDGND), MX_D_1.4 (LEDGND), MX_END_1.4 (LEDGND), MX_ENTER_1.4 (LEDGND), MX_EQUALS_1.4 (LEDGND), MX_ESC_1.4 (LEDGND), MX_E_1.4 (LEDGND), MX_F1_1.4 (LEDGND), MX_F2_1.4 (LEDGND), MX_F3_1.4 (LEDGND), MX_F4_1.4 (LEDGND), MX_F5_1.4 (LEDGND), MX_F6_1.4 (LEDGND), MX_F7_1.4 (LEDGND), MX_F8_1.4 (LEDGND), MX_F9_1.4 (LEDGND), MX_F10_1.4 (LEDGND), MX_F11_1.4 (LEDGND), MX_F12_1.4 (LEDGND), MX_FN_1.4 (LEDGND), MX_F_1.4 (LEDGND), MX_G_1.4 (LEDGND), MX_HOME_1.4 (LEDGND), MX_H_1.4 (LEDGND), MX_I_1.4 (LEDGND), MX_J_1.4 (LEDGND), MX_K_1.4 (LEDGND), MX_LALT_1.4 (LEDGND), MX_LBRAC_1.4 (LEDGND), MX_LCTRL_1.4 (LEDGND), MX_LEFT_1.4 (LEDGND), MX_LSHIFT_1.4 (LEDGND), MX_L_1.4 (LEDGND), MX_MINUS_1.4 (LEDGND), MX_M_1.4 (LEDGND), MX_N_1.4 (LEDGND), MX_OS_1.4 (LEDGND), MX_O_1.4 (LEDGND), MX_PAUSE_1.4 (LEDGND), MX_PGDN_1.4 (LEDGND), MX_PGUP_1.4 (LEDGND), MX_PRTSC_1.4 (LEDGND), MX_P_1.4 (LEDGND), MX_QUOTE_1.4 (LEDGND), MX_Q_1.4 (LEDGND), MX_RALT_1.4 (LEDGND), MX_RBRAC_1.4 (LEDGND), MX_RCTRL_1.4 (LEDGND), MX_RIGHT_1.4 (LEDGND), MX_RSHIFT_1.4 (LEDGND), MX_R_1.4 (LEDGND), MX_SEMIC_1.4 (LEDGND), MX_SLASH_1.4 (LEDGND), MX_SPACE_1.4 (LEDGND), MX_S_1.4 (LEDGND), MX_TAB_1.4 (LEDGND), MX_TILDE_1.4 (LEDGND), MX_T_1.4 (LEDGND), MX_UP_1.4 (LEDGND), MX_U_1.4 (LEDGND), MX_V_1.4 (LEDGND), MX_W_1.4 (LEDGND), MX_X_1.4 (LEDGND), MX_Y_1.4 (LEDGND), MX_Z_1.4 (LEDGND); also elsewhere on the board
unnamed: D_0_1.2 (A), MX_0_1.2 (ROW)
unnamed: D_1_1.2 (A), MX_1_1.2 (ROW)
unnamed: D_2_1.2 (A), MX_2_1.2 (ROW)
unnamed: D_3_1.2 (A), MX_3_1.2 (ROW)
unnamed: D_4_1.2 (A), MX_4_1.2 (ROW)
unnamed: D_5_1.2 (A), MX_5_1.2 (ROW)
unnamed: D_6_1.2 (A), MX_6_1.2 (ROW)
unnamed: D_7_1.2 (A), MX_7_1.2 (ROW)
unnamed: D_8_1.2 (A), MX_8_1.2 (ROW)
unnamed: D_9_1.2 (A), MX_9_1.2 (ROW)
unnamed: D_A_1.2 (A), MX_A_1.2 (ROW)
unnamed: D_BSLSH_1.2 (A), MX_BSLSH_1.2 (ROW)
unnamed: D_BSPACE_1.2 (A), MX_BSPACE_1.2 (ROW)
unnamed: D_B_1.2 (A), MX_B_1.2 (ROW)
unnamed: D_CAPS_1.2 (A), MX_CAPS_1.2 (ROW)
unnamed: D_COMMA_1.2 (A), MX_COMMA_1.2 (ROW)
unnamed: D_C_1.2 (A), MX_C_1.2 (ROW)
unnamed: D_DEL_1.2 (A), MX_DEL_1.2 (ROW)
unnamed: D_DOT_1.2 (A), MX_DOT_1.2 (ROW)
unnamed: D_DOWN_1.2 (A), MX_DOWN_1.2 (ROW)
unnamed: D_D_1.2 (A), MX_D_1.2 (ROW)
unnamed: D_END_1.2 (A), MX_END_1.2 (ROW)
unnamed: D_ENTER_1.2 (A), MX_ENTER_1.2 (ROW)
unnamed: D_EQUALS_1.2 (A), MX_EQUALS_1.2 (ROW)
unnamed: D_ESC_1.2 (A), MX_ESC_1.2 (ROW)
unnamed: D_E_1.2 (A), MX_E_1.2 (ROW)
unnamed: D_F1_1.2 (A), MX_F1_1.2 (ROW)
unnamed: D_F2_1.2 (A), MX_F2_1.2 (ROW)
unnamed: D_F3_1.2 (A), MX_F3_1.2 (ROW)
unnamed: D_F4_1.2 (A), MX_F4_1.2 (ROW)
unnamed: D_F5_1.2 (A), MX_F5_1.2 (ROW)
unnamed: D_F6_1.2 (A), MX_F6_1.2 (ROW)
unnamed: D_F7_1.2 (A), MX_F7_1.2 (ROW)
unnamed: D_F8_1.2 (A), MX_F8_1.2 (ROW)
unnamed: D_F9_1.2 (A), MX_F9_1.2 (ROW)
unnamed: D_F10_1.2 (A), MX_F10_1.2 (ROW)
unnamed: D_F11_1.2 (A), MX_F11_1.2 (ROW)
unnamed: D_F12_1.2 (A), MX_F12_1.2 (ROW)
unnamed: D_FN_1.2 (A), MX_FN_1.2 (ROW)
unnamed: D_F_1.2 (A), MX_F_1.2 (ROW)
unnamed: D_G_1.2 (A), MX_G_1.2 (ROW)
unnamed: D_HOME_1.2 (A), MX_HOME_1.2 (ROW)
unnamed: D_H_1.2 (A), MX_H_1.2 (ROW)
unnamed: D_I_1.2 (A), MX_I_1.2 (ROW)
unnamed: D_J_1.2 (A), MX_J_1.2 (ROW)
unnamed: D_K_1.2 (A), MX_K_1.2 (ROW)
unnamed: D_LALT_1.2 (A), MX_LALT_1.2 (ROW)
unnamed: D_LBRAC_1.2 (A), MX_LBRAC_1.2 (ROW)
unnamed: D_LCTRL_1.2 (A), MX_LCTRL_1.2 (ROW)
unnamed: D_LEFT_1.2 (A), MX_LEFT_1.2 (ROW)
unnamed: D_LSHIFT_1.2 (A), MX_LSHIFT_1.2 (ROW)
unnamed: D_L_1.2 (A), MX_L_1.2 (ROW)
unnamed: D_MINUS_1.2 (A), MX_MINUS_1.2 (ROW)
unnamed: D_M_1.2 (A), MX_M_1.2 (ROW)
unnamed: D_N_1.2 (A), MX_N_1.2 (ROW)
unnamed: D_OS_1.2 (A), MX_OS_1.2 (ROW)
unnamed: D_O_1.2 (A), MX_O_1.2 (ROW)
unnamed: D_PAUSE_1.2 (A), MX_PAUSE_1.2 (ROW)
unnamed: D_PGDN_1.2 (A), MX_PGDN_1.2 (ROW)
unnamed: D_PGUP_1.2 (A), MX_PGUP_1.2 (ROW)
unnamed: D_PRTSC_1.2 (A), MX_PRTSC_1.2 (ROW)
unnamed: D_P_1.2 (A), MX_P_1.2 (ROW)
unnamed: D_QUOTE_1.2 (A), MX_QUOTE_1.2 (ROW)
unnamed: D_Q_1.2 (A), MX_Q_1.2 (ROW)
unnamed: D_RALT_1.2 (A), MX_RALT_1.2 (ROW)
unnamed: D_RBRAC_1.2 (A), MX_RBRAC_1.2 (ROW)
unnamed: D_RCTRL_1.2 (A), MX_RCTRL_1.2 (ROW)
unnamed: D_RIGHT_1.2 (A), MX_RIGHT_1.2 (ROW)
unnamed: D_RSHIFT_1.2 (A), MX_RSHIFT_1.2 (ROW)
unnamed: D_R_1.2 (A), MX_R_1.2 (ROW)
unnamed: D_SEMIC_1.2 (A), MX_SEMIC_1.2 (ROW)
unnamed: D_SLASH_1.2 (A), MX_SLASH_1.2 (ROW)
unnamed: D_SPACE_1.2 (A), MX_SPACE_1.2 (ROW)
unnamed: D_S_1.2 (A), MX_S_1.2 (ROW)
unnamed: D_TAB_1.2 (A), MX_TAB_1.2 (ROW)
unnamed: D_TILDE_1.2 (A), MX_TILDE_1.2 (ROW)
unnamed: D_T_1.2 (A), MX_T_1.2 (ROW)
unnamed: D_UP_1.2 (A), MX_UP_1.2 (ROW)
unnamed: D_U_1.2 (A), MX_U_1.2 (ROW)
unnamed: D_V_1.2 (A), MX_V_1.2 (ROW)
unnamed: D_W_1.2 (A), MX_W_1.2 (ROW)
unnamed: D_X_1.2 (A), MX_X_1.2 (ROW)
unnamed: D_Y_1.2 (A), MX_Y_1.2 (ROW)
unnamed: D_Z_1.2 (A), MX_Z_1.2 (ROW)
unnamed: MX_0_1.3 (LED), R_0_1.1
unnamed: MX_1_1.3 (LED), R_1_1.1
unnamed: MX_2_1.3 (LED), R_2_1.1
unnamed: MX_3_1.3 (LED), R_3_1.1
unnamed: MX_4_1.3 (LED), R_4_1.1
unnamed: MX_5_1.3 (LED), R_5_1.1
unnamed: MX_6_1.3 (LED), R_6_1.1
unnamed: MX_7_1.3 (LED), R_7_1.1
unnamed: MX_8_1.3 (LED), R_8_1.1
unnamed: MX_9_1.3 (LED), R_9_1.1
unnamed: MX_A_1.3 (LED), R_A_1.1
unnamed: MX_BSLSH_1.3 (LED), R_BSLSH_1.1
unnamed: MX_BSPACE_1.3 (LED), R_BSPACE_1.1
unnamed: MX_B_1.3 (LED), R_B_1.1
unnamed: MX_CAPS_1.3 (LED), R_CAPS_1.1
unnamed: MX_COMMA_1.3 (LED), R_COMMA_1.1
unnamed: MX_C_1.3 (LED), R_C_1.1
unnamed: MX_DEL_1.3 (LED), R_DEL_1.1
unnamed: MX_DOT_1.3 (LED), R_DOT_1.1
unnamed: MX_DOWN_1.3 (LED), R_DOWN_1.1
unnamed: MX_D_1.3 (LED), R_D_1.1
unnamed: MX_END_1.3 (LED), R_END_1.1
unnamed: MX_ENTER_1.3 (LED), R_ENTER_1.1
unnamed: MX_EQUALS_1.3 (LED), R_EQUALS_1.1
unnamed: MX_ESC_1.3 (LED), R_ESC_1.1
unnamed: MX_E_1.3 (LED), R_E_1.1
unnamed: MX_F1_1.3 (LED), R_F1_1.1
unnamed: MX_F2_1.3 (LED), R_F2_1.1
unnamed: MX_F3_1.3 (LED), R_F3_1.1
unnamed: MX_F4_1.3 (LED), R_F4_1.1
unnamed: MX_F5_1.3 (LED), R_F5_1.1
unnamed: MX_F6_1.3 (LED), R_F6_1.1
unnamed: MX_F7_1.3 (LED), R_F7_1.1
unnamed: MX_F8_1.3 (LED), R_F8_1.1
unnamed: MX_F9_1.3 (LED), R_F9_1.1
unnamed: MX_F10_1.3 (LED), R_F10_1.1
unnamed: MX_F11_1.3 (LED), R_F11_1.1
unnamed: MX_F12_1.3 (LED), R_F12_1.1
unnamed: MX_FN_1.3 (LED), R_FN_1.1
unnamed: MX_F_1.3 (LED), R_F_1.1
unnamed: MX_G_1.3 (LED), R_G_1.1
unnamed: MX_HOME_1.3 (LED), R_HOME_1.1
unnamed: MX_H_1.3 (LED), R_H_1.1
unnamed: MX_I_1.3 (LED), R_I_1.1
unnamed: MX_J_1.3 (LED), R_J_1.1
unnamed: MX_K_1.3 (LED), R_K_1.1
unnamed: MX_LALT_1.3 (LED), R_LALT_1.1
unnamed: MX_LBRAC_1.3 (LED), R_LBRAC_1.1
unnamed: MX_LCTRL_1.3 (LED), R_LCTRL_1.1
unnamed: MX_LEFT_1.3 (LED), R_LEFT_1.1
unnamed: MX_LSHIFT_1.3 (LED), R_LSHIFT_1.1
unnamed: MX_L_1.3 (LED), R_L_1.1
unnamed: MX_MINUS_1.3 (LED), R_MINUS_1.1
unnamed: MX_M_1.3 (LED), R_M_1.1
unnamed: MX_N_1.3 (LED), R_N_1.1
unnamed: MX_OS_1.3 (LED), R_OS_1.1
unnamed: MX_O_1.3 (LED), R_O_1.1
unnamed: MX_PAUSE_1.3 (LED), R_PAUSE_1.1
unnamed: MX_PGDN_1.3 (LED), R_PGDN_1.1
unnamed: MX_PGUP_1.3 (LED), R_PGUP_1.1
unnamed: MX_PRTSC_1.3 (LED), R_PRTSC_1.1
unnamed: MX_P_1.3 (LED), R_P_1.1
unnamed: MX_QUOTE_1.3 (LED), R_QUOTE_1.1
unnamed: MX_Q_1.3 (LED), R_Q_1.1
unnamed: MX_RALT_1.3 (LED), R_RALT_1.1
unnamed: MX_RBRAC_1.3 (LED), R_RBRAC_1.1
unnamed: MX_RCTRL_1.3 (LED), R_RCTRL_1.1
unnamed: MX_RIGHT_1.3 (LED), R_RIGHT_1.1
unnamed: MX_RSHIFT_1.3 (LED), R_RSHIFT_1.1
unnamed: MX_R_1.3 (LED), R_R_1.1
unnamed: MX_SEMIC_1.3 (LED), R_SEMIC_1.1
unnamed: MX_SLASH_1.3 (LED), R_SLASH_1.1
unnamed: MX_SPACE_1.3 (LED), R_SPACE_1.1
unnamed: MX_S_1.3 (LED), R_S_1.1
unnamed: MX_TAB_1.3 (LED), R_TAB_1.1
unnamed: MX_TILDE_1.3 (LED), R_TILDE_1.1
unnamed: MX_T_1.3 (LED), R_T_1.1
unnamed: MX_UP_1.3 (LED), R_UP_1.1
unnamed: MX_U_1.3 (LED), R_U_1.1
unnamed: MX_V_1.3 (LED), R_V_1.1
unnamed: MX_W_1.3 (LED), R_W_1.1
unnamed: MX_X_1.3 (LED), R_X_1.1
unnamed: MX_Y_1.3 (LED), R_Y_1.1
unnamed: MX_Z_1.3 (LED), R_Z_1.1
col0: MX_CAPS_1.1 (COL), MX_ESC_1.1 (COL), MX_LCTRL_1.1 (COL), MX_TAB_1.1 (COL), MX_TILDE_1.1 (COL); also elsewhere on the board
col1: MX_1_1.1 (COL), MX_F1_1.1 (COL), MX_LSHIFT_1.1 (COL), MX_OS_1.1 (COL); also elsewhere on the board
col2: MX_2_1.1 (COL), MX_A_1.1 (COL), MX_F2_1.1 (COL), MX_Q_1.1 (COL), MX_Z_1.1 (COL); also elsewhere on the board
col3: MX_3_1.1 (COL), MX_F3_1.1 (COL), MX_LALT_1.1 (COL), MX_S_1.1 (COL), MX_W_1.1 (COL), MX_X_1.1 (COL); also elsewhere on the board
col4: MX_4_1.1 (COL), MX_C_1.1 (COL), MX_D_1.1 (COL), MX_E_1.1 (COL), MX_F4_1.1 (COL); also elsewhere on the board
col5: MX_5_1.1 (COL), MX_F5_1.1 (COL), MX_F_1.1 (COL), MX_R_1.1 (COL), MX_V_1.1 (COL); also elsewhere on the board
col6: MX_6_1.1 (COL), MX_B_1.1 (COL), MX_F6_1.1 (COL), MX_G_1.1 (COL), MX_SPACE_1.1 (COL), MX_T_1.1 (COL); also elsewhere on the board
col7: MX_7_1.1 (COL), MX_F7_1.1 (COL), MX_H_1.1 (COL), MX_N_1.1 (COL), MX_Y_1.1 (COL); also elsewhere on the board
col8: MX_8_1.1 (COL), MX_F8_1.1 (COL), MX_J_1.1 (COL), MX_M_1.1 (COL), MX_U_1.1 (COL); also elsewhere on the board
col9: MX_9_1.1 (COL), MX_COMMA_1.1 (COL), MX_F9_1.1 (COL), MX_I_1.1 (COL), MX_K_1.1 (COL); also elsewhere on the board
col10: MX_0_1.1 (COL), MX_DOT_1.1 (COL), MX_F10_1.1 (COL), MX_L_1.1 (COL), MX_O_1.1 (COL), MX_RALT_1.1 (COL); also elsewhere on the board
col11: MX_F11_1.1 (COL), MX_FN_1.1 (COL), MX_MINUS_1.1 (COL), MX_P_1.1 (COL), MX_SEMIC_1.1 (COL), MX_SLASH_1.1 (COL); also elsewhere on the board
col12: MX_EQUALS_1.1 (COL), MX_F12_1.1 (COL), MX_LBRAC_1.1 (COL), MX_QUOTE_1.1 (COL), MX_RCTRL_1.1 (COL); also elsewhere on the board
col13: MX_ENTER_1.1 (COL), MX_LEFT_1.1 (COL), MX_PRTSC_1.1 (COL), MX_RBRAC_1.1 (COL), MX_RSHIFT_1.1 (COL); also elsewhere on the board
col14: MX_BSLSH_1.1 (COL), MX_BSPACE_1.1 (COL), MX_DOWN_1.1 (COL), MX_PAUSE_1.1 (COL), MX_UP_1.1 (COL); also elsewhere on the board
col15: MX_DEL_1.1 (COL), MX_END_1.1 (COL), MX_HOME_1.1 (COL), MX_PGDN_1.1 (COL), MX_PGUP_1.1 (COL), MX_RIGHT_1.1 (COL); also elsewhere on the board
row0: D_DEL_1.1 (K), D_ESC_1.1 (K), D_F1_1.1 (K), D_F2_1.1 (K), D_F3_1.1 (K), D_F4_1.1 (K), D_F5_1.1 (K), D_F6_1.1 (K), D_F7_1.1 (K), D_F8_1.1 (K), D_F9_1.1 (K), D_F10_1.1 (K), D_F11_1.1 (K), D_F12_1.1 (K), D_PAUSE_1.1 (K), D_PRTSC_1.1 (K); also elsewhere on the board
row1: D_0_1.1 (K), D_1_1.1 (K), D_2_1.1 (K), D_3_1.1 (K), D_4_1.1 (K), D_5_1.1 (K), D_6_1.1 (K), D_7_1.1 (K), D_8_1.1 (K), D_9_1.1 (K), D_BSPACE_1.1 (K), D_EQUALS_1.1 (K), D_HOME_1.1 (K), D_MINUS_1.1 (K), D_TILDE_1.1 (K); also elsewhere on the board
row2: D_BSLSH_1.1 (K), D_E_1.1 (K), D_I_1.1 (K), D_LBRAC_1.1 (K), D_O_1.1 (K), D_PGUP_1.1 (K), D_P_1.1 (K), D_Q_1.1 (K), D_RBRAC_1.1 (K), D_R_1.1 (K), D_TAB_1.1 (K), D_T_1.1 (K), D_U_1.1 (K), D_W_1.1 (K), D_Y_1.1 (K); also elsewhere on the board
row3: D_A_1.1 (K), D_CAPS_1.1 (K), D_D_1.1 (K), D_ENTER_1.1 (K), D_F_1.1 (K), D_G_1.1 (K), D_H_1.1 (K), D_J_1.1 (K), D_K_1.1 (K), D_L_1.1 (K), D_PGDN_1.1 (K), D_QUOTE_1.1 (K), D_SEMIC_1.1 (K), D_S_1.1 (K); also elsewhere on the board
row4: D_B_1.1 (K), D_COMMA_1.1 (K), D_C_1.1 (K), D_DOT_1.1 (K), D_END_1.1 (K), D_LSHIFT_1.1 (K), D_M_1.1 (K), D_N_1.1 (K), D_RSHIFT_1.1 (K), D_SLASH_1.1 (K), D_UP_1.1 (K), D_V_1.1 (K), D_X_1.1 (K), D_Z_1.1 (K); also elsewhere on the board
row5: D_DOWN_1.1 (K), D_FN_1.1 (K), D_LALT_1.1 (K), D_LCTRL_1.1 (K), D_LEFT_1.1 (K), D_OS_1.1 (K), D_RALT_1.1 (K), D_RCTRL_1.1 (K), D_RIGHT_1.1 (K), D_SPACE_1.1 (K); also elsewhere on the board

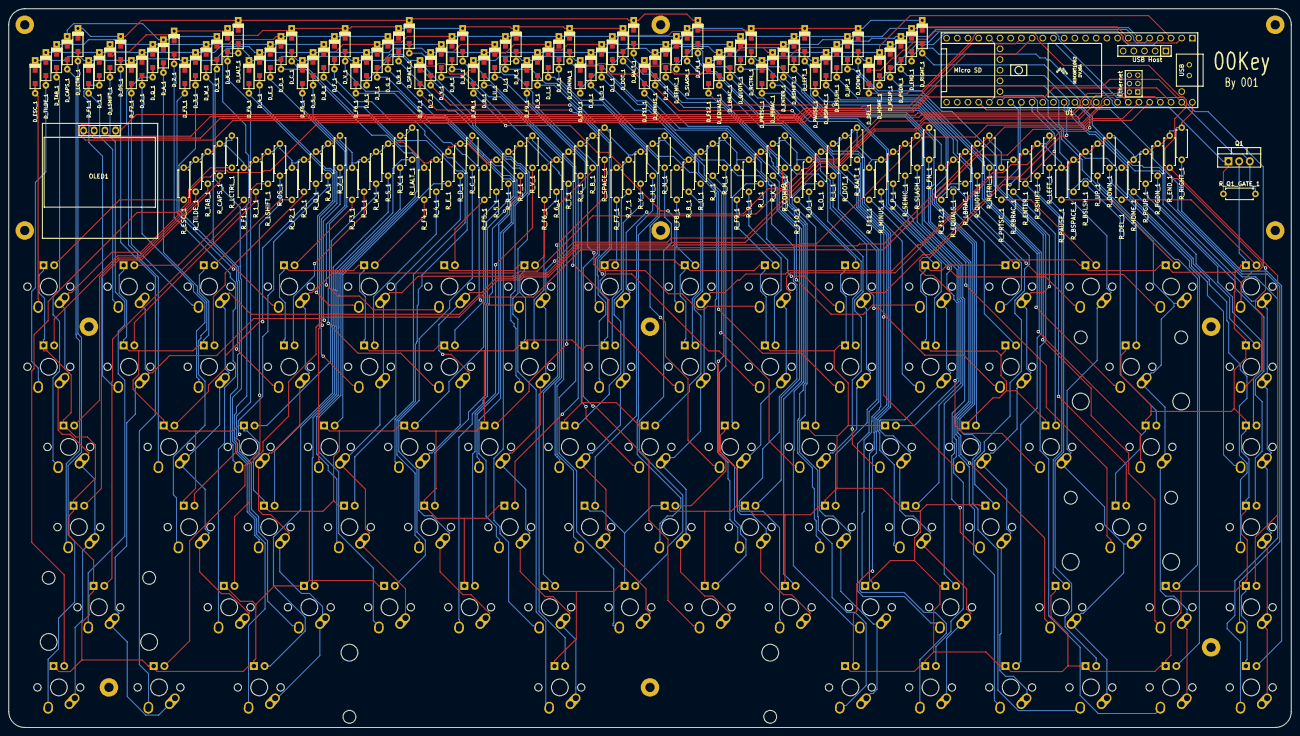
[picture p29: board 00Key.kicad_pcb from above]

Board: 2 copper layers, 304.8 x 170.8 mm, 268 parts (0 on the bottom side), 197 nets.

Other parts of the board:
H_KEYS_BL: MountingHole_2.2mm_M2_Pad
H_KEYS_BM: MountingHole_2.2mm_M2_Pad
H_KEYS_BR: MountingHole_2.2mm_M2_Pad
H_KEYS_TL: MountingHole_2.2mm_M2_Pad
H_KEYS_TM: MountingHole_2.2mm_M2_Pad
H_KEYS_TR: MountingHole_2.2mm_M2_Pad
H_PLATE_BL: MountingHole_2.2mm_M2_Pad
H_PLATE_BR: MountingHole_2.2mm_M2_Pad
H_PLATE_MB: MountingHole_2.2mm_M2_Pad
H_PLATE_TL: MountingHole_2.2mm_M2_Pad
H_PLATE_TM: MountingHole_2.2mm_M2_Pad
H_PLATE_TR: MountingHole_2.2mm_M2_Pad
