yang-json/60Keyboard/00Key-master/firmware/src/main.cpp

#include <Arduino.h>
#include "Globals.h"
#include "KeyMap.h"
#include "OLED.h"
#include "Backlight.h"
#include "Underglow.h"
#include "Scanner.h"
#include "Storage.h"
#include "Actions.h"

void setup()
{
  OLED::setup();
  Backlight::setup();
  Underglow::setup();
  Scanner::setup();
}

void loop()
{
  Scanner::loop();
  Actions::loop();
  OLED::loop();
  Underglow::loop();
  delay(SCAN_DELAY);
}
