yang-json/60Keyboard/00Key-master/firmware/include/OLED.h

#ifndef OLED_h
#define OLED_h

class OLED
{
public:
    static void setup();
    static void loop();
    static void setLayer(int layer);
    static void setBacklight(int percentage);
    static void toggleCaps();
    static void setUnderglow(int red, int green, int blue);
};

#endif
