yang-json/60Keyboard/00Key-master/firmware/include/Underglow.h

#ifndef Underglow_h
#define Underglow_h

enum class RGBColor: int
{
    RED,
    GREEN,
    BLUE
};

class Underglow
{
public:
    static void setup();
    static void loop();
    static void set(int red, int green, int blue);
    static void add(int red, int green, int blue);
};

#endif
