yang-json/60Keyboard/(commit log)

2024-01-08 Board images and libraries
    [a1d715fa3ec649b463cb42fbbe5cdb0abbd753b8_switch.dwg, a1d715fa3ec649b463cb42fbbe5cdb0abbd753b8_switch.dxf]
2024-01-08 Uploaded keyboard cad files
    [00Key-out.dsn, 00Key.dsn, 00Key.kicad_pcb, 00Key.sch, left.stl, raiser.FCStd, raiser.stl, right.stl]
